kuro68k/PowerShift/hardware/data/webench_design_3873230_42_814646582.pdf

## WEBENCH ® Design Report

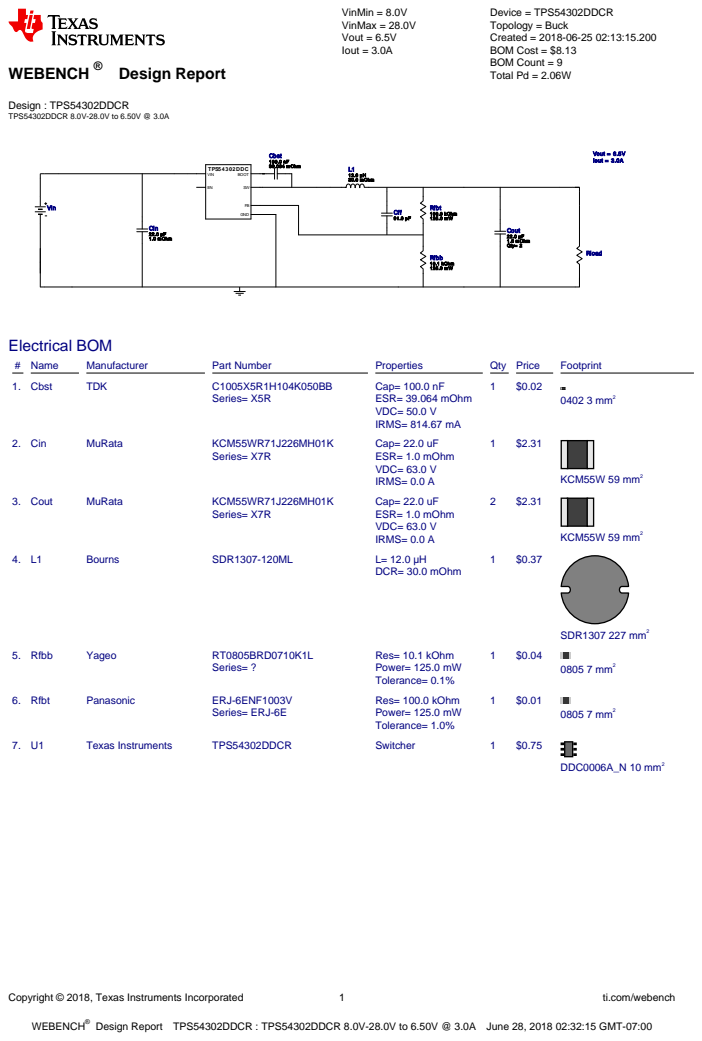
[picture p1: page 1]
Copyright © 2018, Texas Instruments Incorporated; ti.com/webench; WEBENCH®; Design : TPS54302DDCR TPS54302DDCR 8.0V-28.0V to 6.50V @ 3.0A; VinMin = 8.0V VinMax = 28.0V Vout = 6.5V Iout = 3.0A; Device = TPS54302DDCR Topology = Buck Created = 2018-06-25 02:13:15.200 BOM Cost = $8.13 BOM Count = 9 Total Pd = 2.06W; Cbst 100.0 nF; 39.064 mOhm; Cin 22.0 µF 1.0 mOhm; Cout 22.0 µF; 1.0 mOhm Qty= 2; L1 12.0 µH 30.0 mOhm; Rfbb 10.1 kOhm 125.0 mW; Rfbt 100.0 kOhm; TPS54302DDC; GND; VIN; BOOT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

Design Report TPS54302DDCR : TPS54302DDCR 8.0V-28.0V to 6.50V @ 3.0A June 28, 2018 02:32:15 GMT-07:00

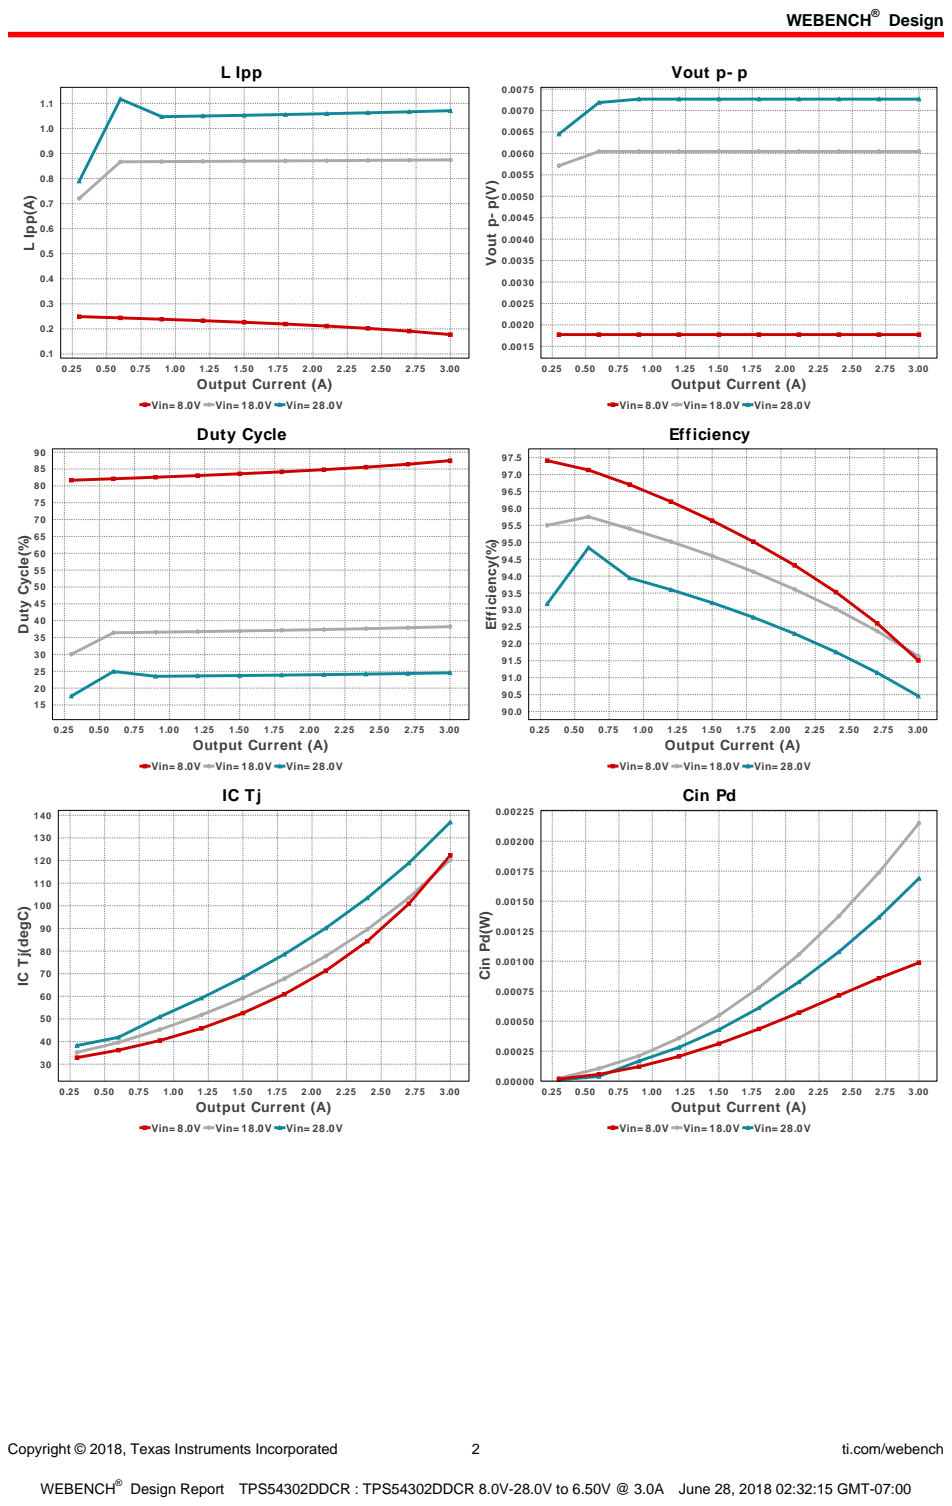
[picture p2: page 2]
Design; Copyright © 2018, Texas Instruments Incorporated; ti.com/webench; L Ipp; 3.00 Output Current (A); L Ipp(A); Vout p- p; Vout p- p(V); Duty Cycle(%); Efficiency(%); Cin Pd; Cin Pd(W)

Vin= 8.0V Vin= 18.0V Vin= 28.0V
Duty Cycle

Efficiency

IC Tj(degC)

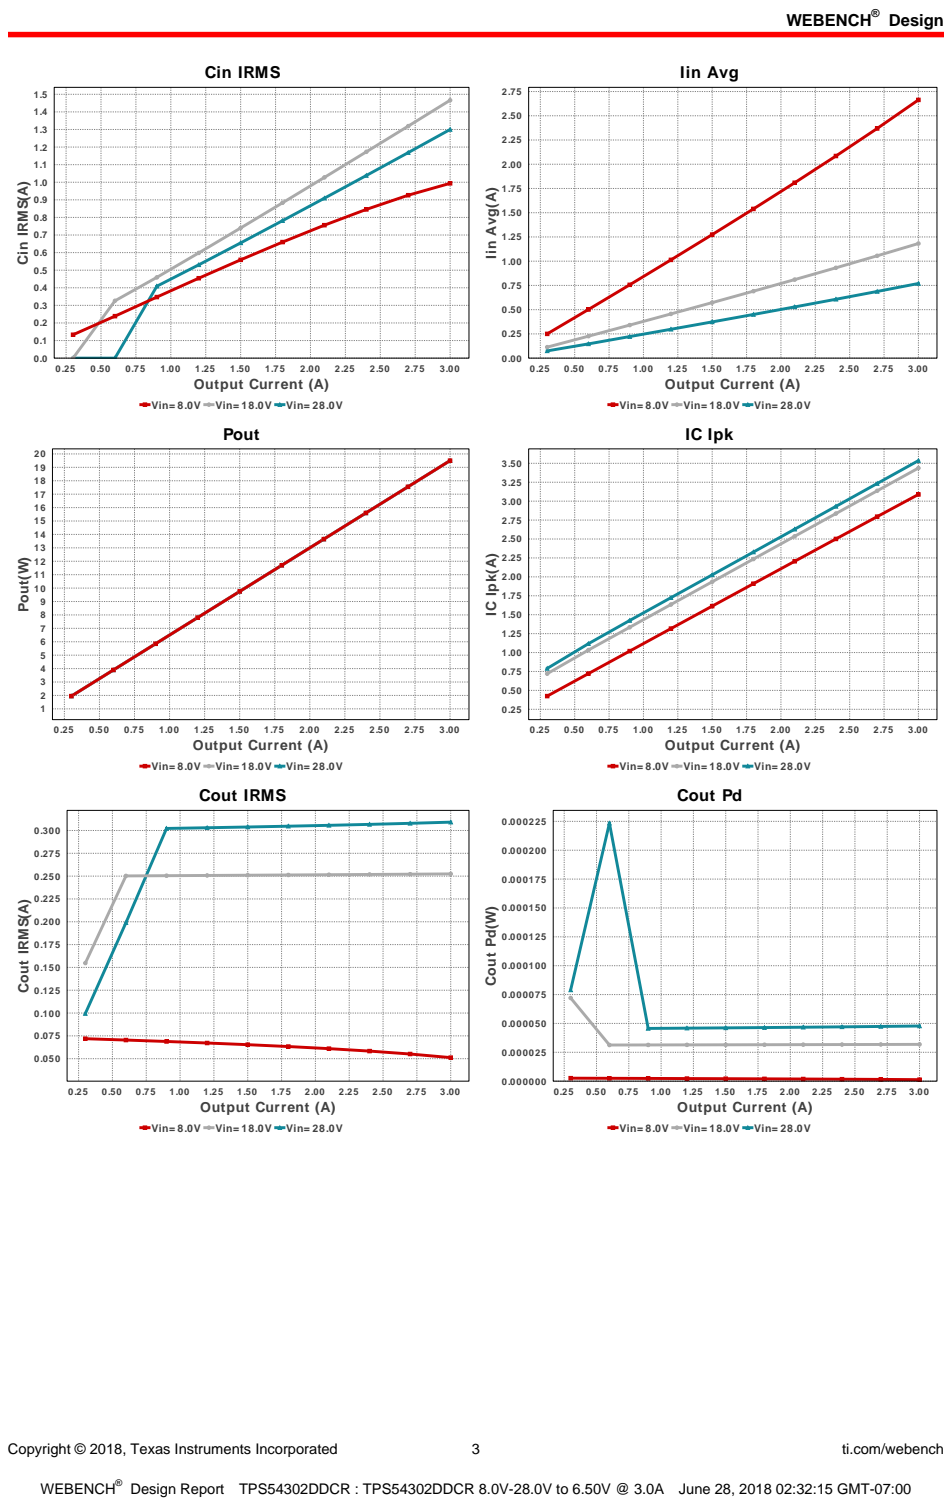
[picture p3: page 3]
Copyright © 2018, Texas Instruments Incorporated; ti.com/webench; Cin IRMS; 3.00 Output Current (A); Cin IRMS(A); Iin Avg; Iin Avg(A); Pout; Pout(W); IC Ipk; IC Ipk(A); Cout IRMS(A); 0.25 0.50 0.75 1.00 1.25 1.50 1.75 2.00 2.25 2.50 2.75 3.00 Output Current (A); Cout Pd(W)

Vin= 8.0V Vin= 18.0V Vin= 28.0V

Cout IRMS

Cout Pd

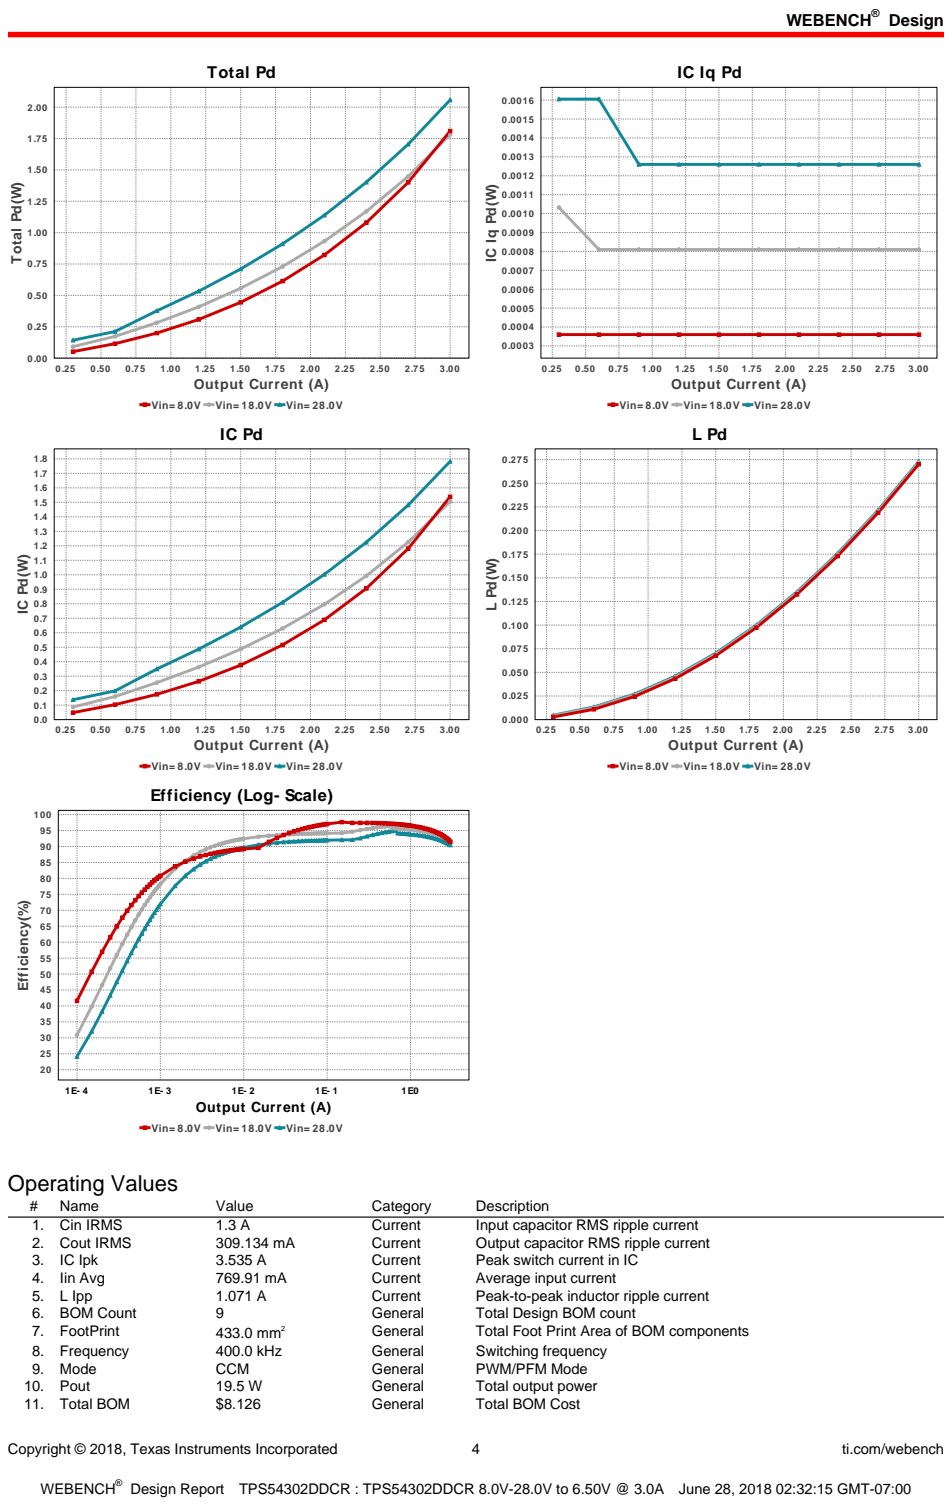
[picture p4: page 4]
Copyright © 2018, Texas Instruments Incorporated; ti.com/webench; Total Pd; 3.00 Output Current (A); Total Pd(W); 1E0 Output Current (A); Efficiency(%); Operating Values; Name; Value; Category; Description; 1. Cin IRMS; Current; Input capacitor RMS ripple current; 2. Cout IRMS; Output capacitor RMS ripple current; 3. IC Ipk; Peak switch current in IC; 4. Iin Avg; Average input current; 5. L Ipp; Peak-to-peak inductor ripple current; 6. BOM Count; General; Total Design BOM count; 7. FootPrint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

Vin= 8.0V Vin= 18.0V Vin= 28.0V

Efficiency (Log- Scale)

Copyright © 2018, Texas Instruments Incorporated | 5 | ti.com/webench
# | Name | Value | Category | Description

12. Duty Cycle | 24.54 % | Op Point | Duty cycle
13. Efficiency | 90.456 % | Op Point | Steady state efficiency
14. IC Tj | 136.945 degC | Op Point | IC junction temperature
15. ICThetaJA Effective | 60.0 degC/W | Op Point | Effective IC Junction-to-Ambient Thermal Resistance
16. IOUT_OP | 3.0 A | Op Point | Iout operating point
17. VIN_OP | 28.0 V | Op Point | Vin operating point
18. Vout Actual | 6.497 V | Op Point | Vout Actual calculated based on selected voltage divider resistors
19. Vout Tolerance | 1.0 % | Op Point | Vout Tolerance based on IC Tolerance (no load) and voltage divider
| | | | resistors if applicable
20. Vout p-p | 7.266 mV | Op Point | Peak-to-peak output ripple voltage
21. Cin Pd | 1.69 mW | Power | Input capacitor power dissipation
22. Cout Pd | 47.782 µW | Power | Output capacitor power dissipation
23. IC Iq Pd | 1.26 mW | Power | IC Iq Pd
24. IC Pd | 1.782 W | Power | IC power dissipation
25. L Pd | 272.867 mW | Power | Inductor power dissipation
26. Total Pd | 2.057 W | Power | Total Power Dissipation

## Design Inputs

# | Name | Value | Description

1. Iout | 3.0 | Maximum Output Current
2. VinMax | 28.0 | Maximum input voltage
3. VinMin | 8.0 | Minimum input voltage
4. Vout | 6.5 | Output Voltage
5. acFrequency | 0.0 | AC Frequency
6. base_pn | TPS54302 | Base Product Number
7. source | DC | Input Source Type
8. Ta | 30.0 | Ambient temperature

## Design Assistance

1. TPS54302 Product Folder : http://www.ti.com/product/TPS54302 : contains the data sheet and other resources.

Texas Instruments' WEBENCH simulation tools attempt to recreate the performance of a substantially equivalent physical implementation
of the design. Simulations are created using Texas Instruments' published specifications as well as the published specifications of other device manufacturers. While Texas Instruments does update this information periodically, this information may not be current at the time the simulation is built. Texas Instruments does not warrant the accuracy or completeness of the specifications or any information contained therein. Texas Instruments does not warrant that any designs or recommended parts will meet the specifications you entered, will be suitable for your application or fit for any particular purpose, or will operate as shown in the simulation in a physical implementation. Texas Instruments does not warrant that the designs are production worthy.
You should completely validate and test your design implementation to confirm the system functionality for your application prior to production.
Use of Texas Instruments' WEBENCH simulation tools is subject to Texas Instruments' Site Terms and Conditions of Use. (http://www.ti.com/corp/docs/legal/termsofuse.shtml) Prototype boards based on WEBENCH created designs are provided AS IS without warranty of any kind for evaluation and testing purposes and are subject to the terms of the Evaluation License Agreement. (http://www.ti.com/corp/docs/legal/termsofuse_estore.shtml)
