kuro68k/PowerShift/hardware/PowerShift.pdf

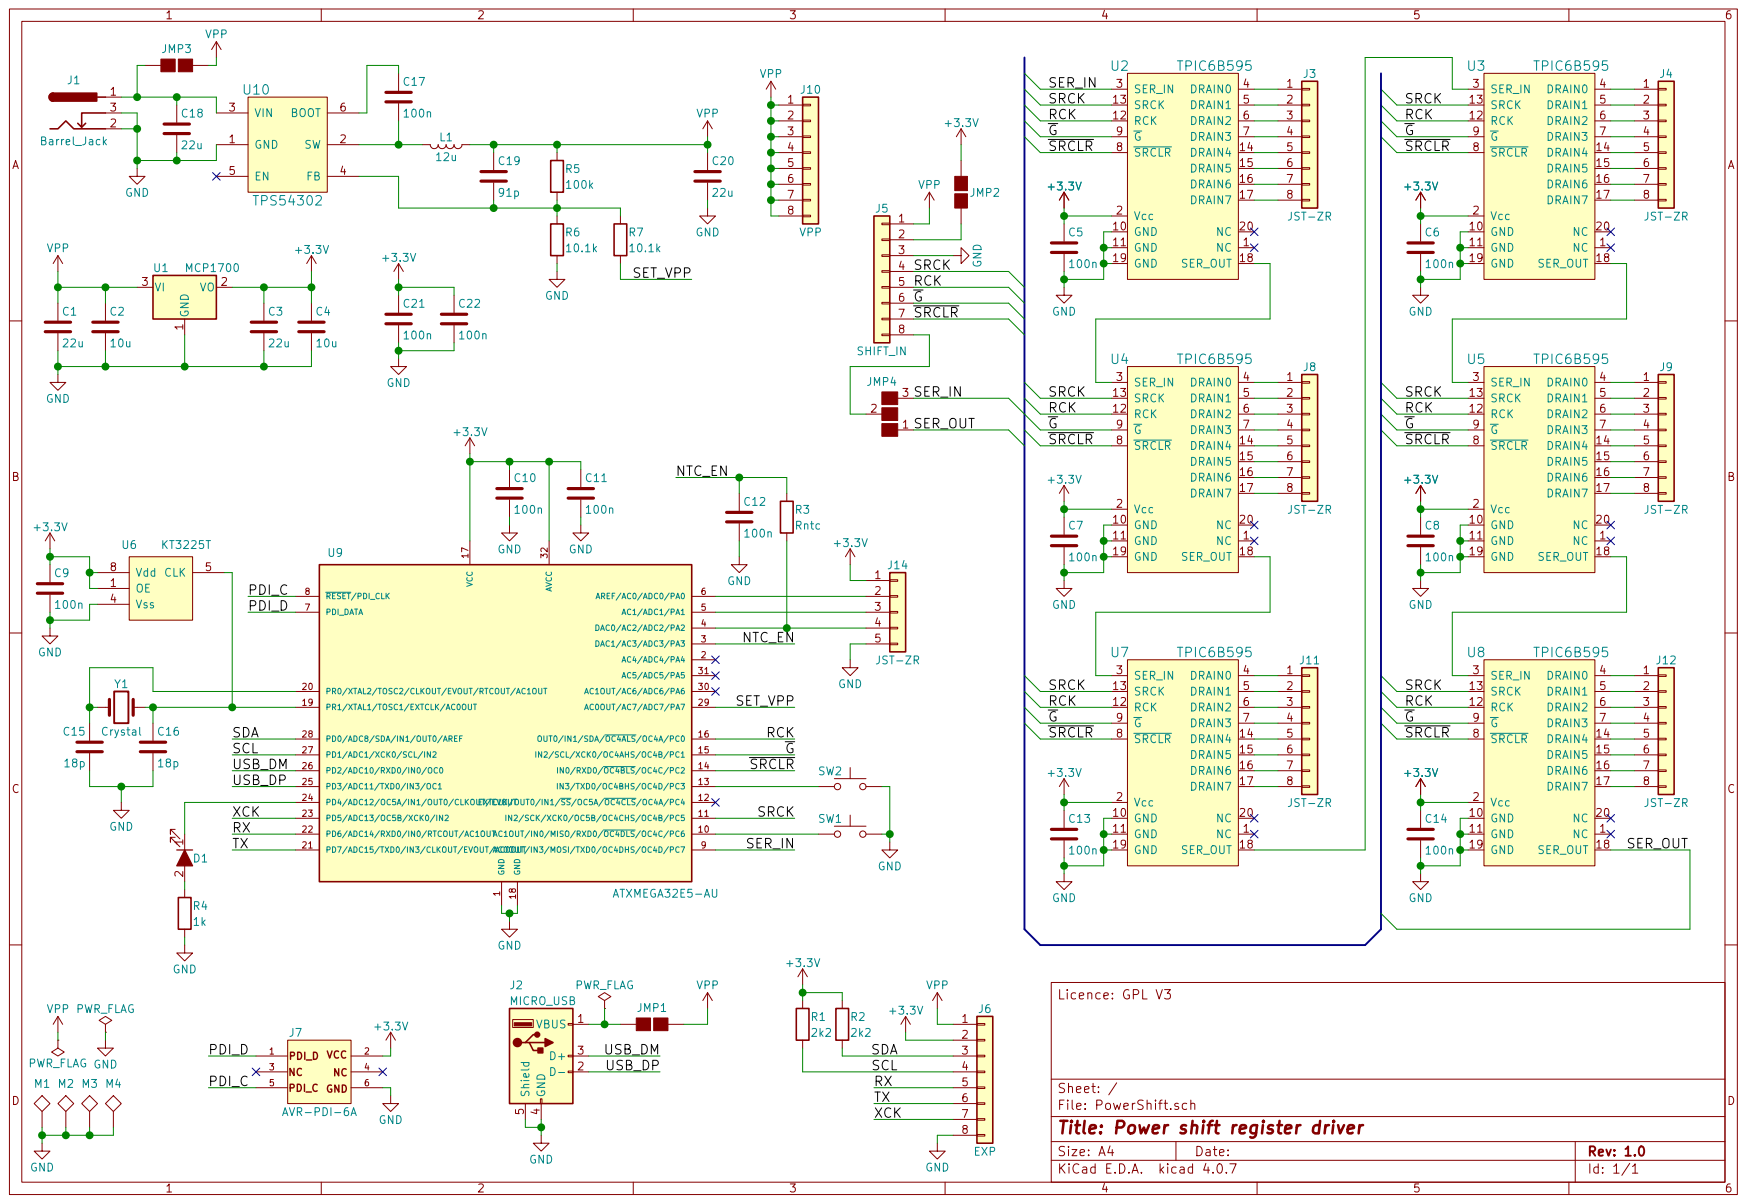
[picture p5: page 1]
