kuro68k/PowerShift/hardware/PowerShift.kicad_pcb

## KiCad design hardware/PowerShift.kicad_pcb (2018-07-08)

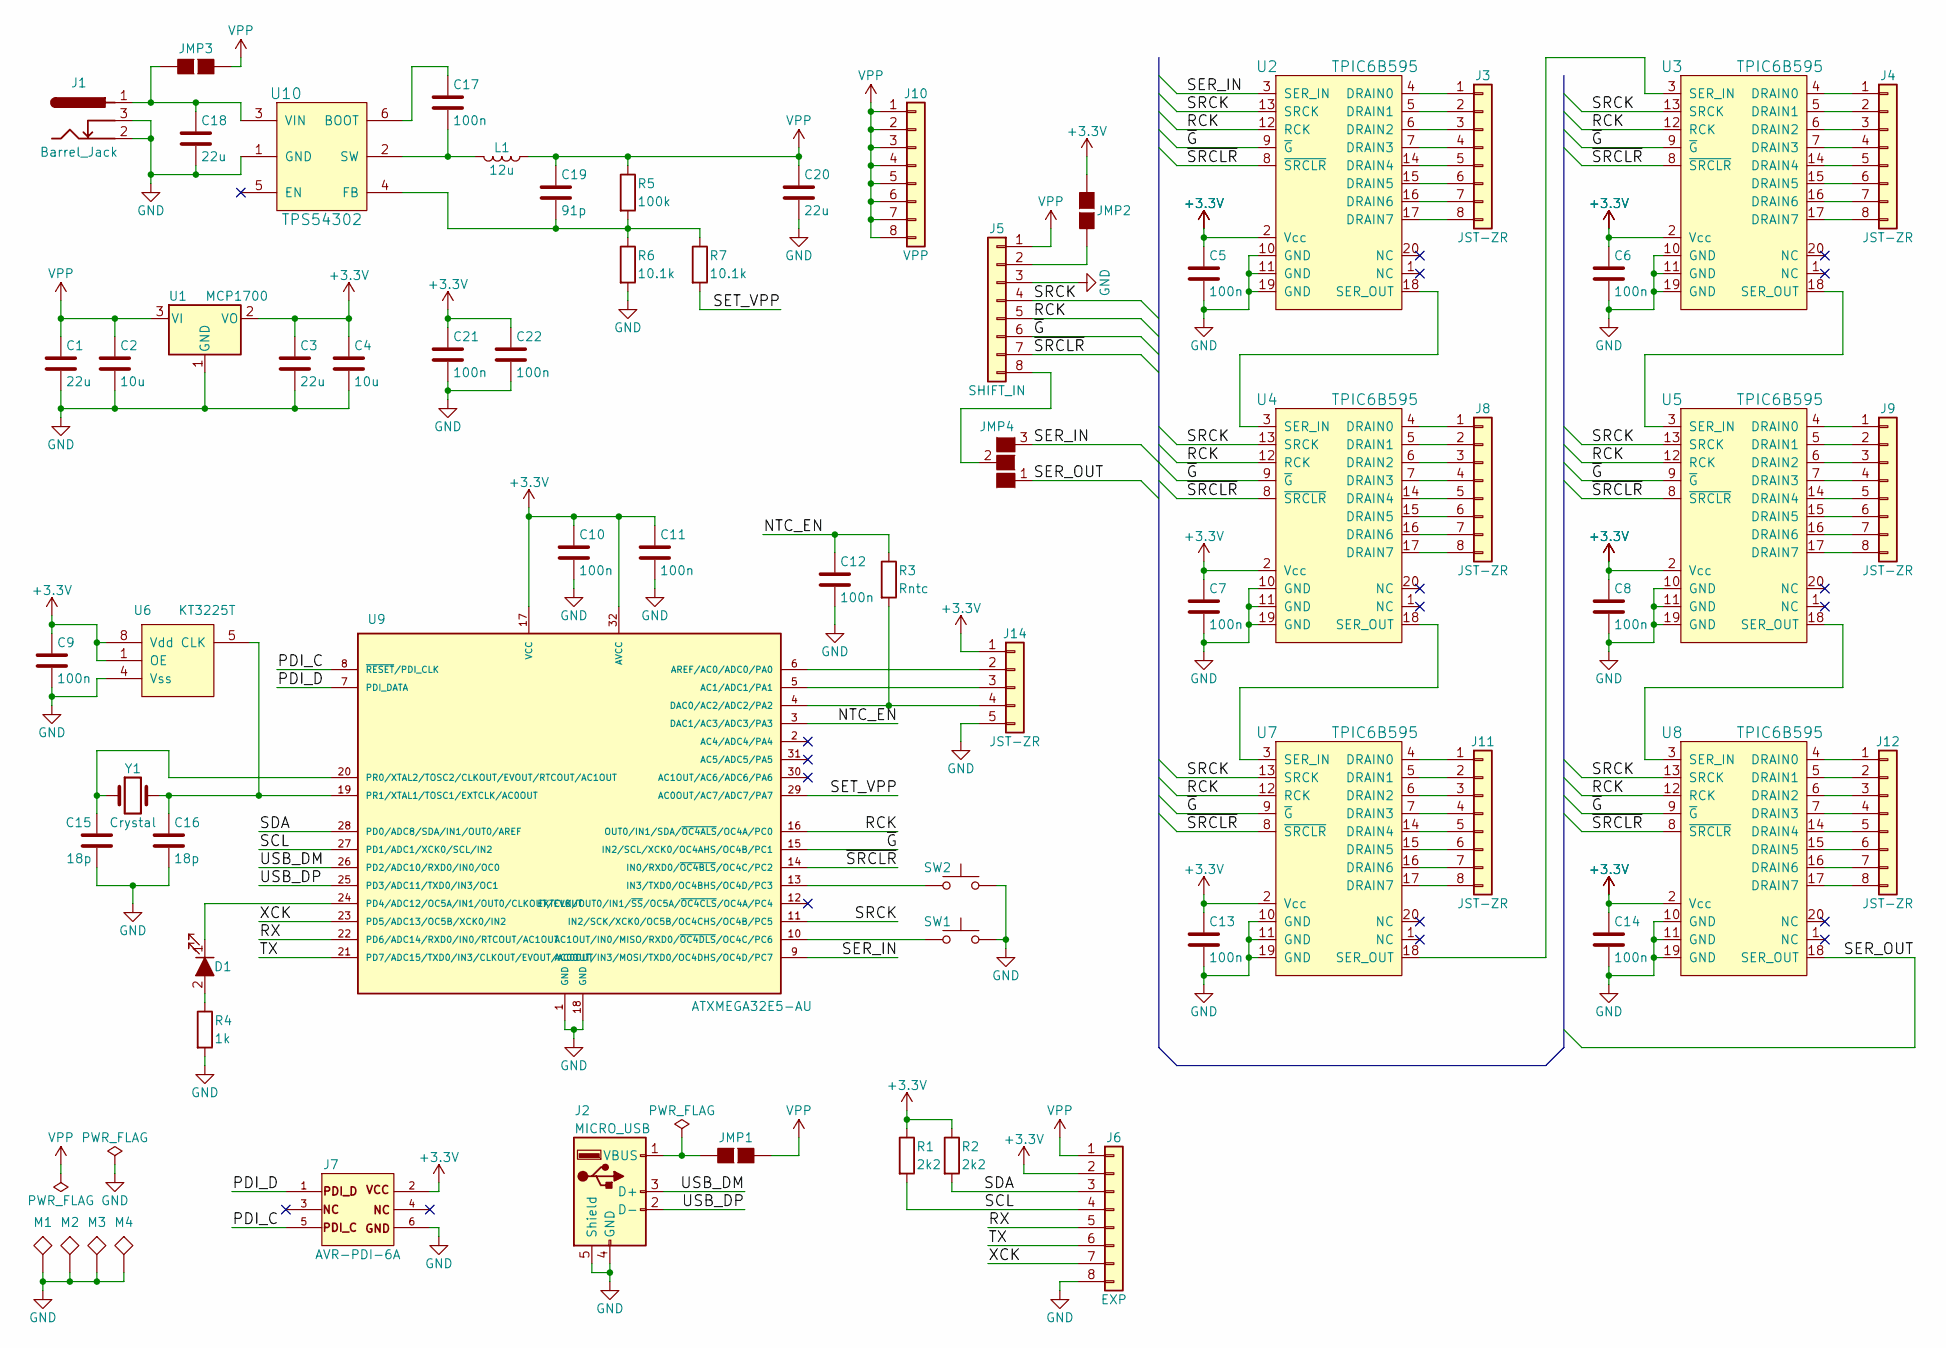
[picture p6: schematic PowerShift.sch, Power shift register driver]

Parts:
C1, C3, C18, C20: 22u; C_0805_HandSoldering
C2, C4: 10u; C_0603_HandSoldering
C5, C6, C7, C8, C9, C10, C11, C12, C13, C14, C17, C21, C22: 100n; C_0603_HandSoldering
C15, C16: 18p; C_0603_HandSoldering
C19: 91p; C_0603_HandSoldering
D1: LED_ALT; LED_0603_HandSoldering
J1: Barrel_Jack; DC_Jack_SMD_FC6814xS_6941
J2: MICRO_USB; Molex_47346-0001_Micro_USB_SMT
J3, J4, J8, J9, J11, J12: JST-ZR; B8B-ZR-SM4-TF
J5: SHIFT_IN; Pin_Header_Straight_1x08_Pitch2.54mm
J6: EXP; B8B-ZR-SM4-TF
J7: AVR-PDI-6A; Pin_Header_Angled_2x03_Pitch2.54mm
J10: VPP; B8B-ZR-SM4-TF
J14: JST-ZR; B5B-ZR-SM4-TF
JMP1, JMP2, JMP3: GS2
JMP4: GS3
L1: 12u; Bourns_SDR1307_14x14mm
M1, M2, M3, M4: TEST; MountingHole_2.7mm_M2.5_Pad
R1, R2: 2k2; R_0603_HandSoldering
R3: Rntc; R_0603_HandSoldering
R4: 1k; R_0603_HandSoldering
R5: 100k; R_0603_HandSoldering
R6, R7: 10.1k; R_0603_HandSoldering
SW1, SW2: SW_Push; Switch_FSM-JSM-Series
U1: MCP1700; SOT-23
U2, U3, U4, U5, U7, U8: TPIC6B595; SOIC-20W_7.5x12.8mm_Pitch1.27mm
U6: KT3225T
U9: ATXMEGA32E5-AU; TQFP-32_7x7mm_Pitch0.8mm
U10: TPS54302; SOT-23-6_Handsoldering
Y1: Crystal; Crystal_2pin_6x3.5_3.2x1.5_Multi

Connections:
+3V3: C3.1, C4.1, C5.1, C6.1, C7.1, C8.1, C9.1, C10.1, C11.1, C13.1, C14.1, C21.1, C22.1, J6.2, J7.2, J14.1, JMP2.1 (G1), R1.1, R2.1, U1.2 (VO), U2.2 (Vcc), U3.2 (Vcc), U4.2 (Vcc), U5.2 (Vcc), U6.1 (OE), U6.8 (Vdd), U7.2 (Vcc), U8.2 (Vcc), U9.17 (VCC), U9.32 (AVCC)
/NTC_EN: C12.1, R3.1, U9.3 (DAC1/AC3/ADC3/PA3)
/PDI_C: J7.5, U9.8 (~RESET~/PDI_CLK)
/PDI_D: J7.1, U9.7 (PDI_DATA)
/RCK: J5.5, U2.12 (RCK), U3.12 (RCK), U4.12 (RCK), U5.12 (RCK), U7.12 (RCK), U8.12 (RCK), U9.16 (OUT0/IN1/SDA/~OC4ALS~/OC4A/PC0)
/RX: J6.5, U9.22 (PD6/ADC14/RXD0/IN0/RTCOUT/AC1OUT)
/SCL: J6.4, R1.2, U9.27 (PD1/ADC1/XCK0/SCL/IN2)
/SDA: J6.3, R2.2, U9.28 (PD0/ADC8/SDA/IN1/OUT0/AREF)
/SER_IN: JMP4.3 (G3), U2.3 (SER_IN), U9.9 (AC0OUT/IN3/MOSI/TXD0/OC4DHS/OC4D/PC7)
/SER_OUT: JMP4.1 (G1), U8.18 (SER_OUT)
/SET_VPP: R7.2, U9.29 (AC0OUT/AC7/ADC7/PA7)
/SRCK: J5.4, U2.13 (SRCK), U3.13 (SRCK), U4.13 (SRCK), U5.13 (SRCK), U7.13 (SRCK), U8.13 (SRCK), U9.11 (IN2/SCK/XCK0/OC5B/OC4CHS/OC4B/PC5)
/TX: J6.6, U9.21 (PD7/ADC15/TXD0/IN3/CLKOUT/EVOUT/AC0OUT)
/USB_DM: J2.3 (D+), U9.26 (PD2/ADC10/RXD0/IN0/OC0)
/USB_DP: J2.2 (D-), U9.25 (PD3/ADC11/TXD0/IN3/OC1)
/XCK: J6.7, U9.23 (PD5/ADC13/OC5B/XCK0/IN2)
/~G: J5.6, U2.9 (~G), U3.9 (~G), U4.9 (~G), U5.9 (~G), U7.9 (~G), U8.9 (~G), U9.15 (IN2/SCL/XCK0/OC4AHS/OC4B/PC1)
/~SRCLR: J5.7, U2.8 (~SRCLR), U3.8 (~SRCLR), U4.8 (~SRCLR), U5.8 (~SRCLR), U7.8 (~SRCLR), U8.8 (~SRCLR), U9.14 (IN0/RXD0/~OC4BLS~/OC4C/PC2)
GND: C1.2, C2.2, C3.2, C4.2, C5.2, C6.2, C7.2, C8.2, C9.2, C10.2, C11.2, C12.2, C13.2, C14.2, C15.2, C16.2, C18.2, C20.2, C21.2, C22.2, J1.2, J1.3, J2.4 (GND), J2.5 (Shield), J5.3, J6.8, J7.6, J14.5, M1.1, M2.1, M3.1, M4.1, R4.2, R6.2, SW1.1, SW2.1, U1.1 (GND), U2.10 (GND), U2.11 (GND), U2.19 (GND), U3.10 (GND), U3.11 (GND), U3.19 (GND), U4.10 (GND), U4.11 (GND), U4.19 (GND), U5.10 (GND), U5.11 (GND), U5.19 (GND), U6.4 (Vss), U7.10 (GND), U7.11 (GND), U7.19 (GND), U8.10 (GND), U8.11 (GND), U8.19 (GND), U9.1 (GND), U9.18 (GND), U10.1 (GND)
unnamed: C15.1, U9.20 (PR0/XTAL2/TOSC2/CLKOUT/EVOUT/RTCOUT/AC1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), Y1.1
unnamed: C16.1, U6.5 (CLK), U9.19 (PR1/XTAL1/TOSC1/EXTCLK/AC0OUT), Y1.2
unnamed: C17.1, U10.6 (BOOT)
unnamed: C17.2, L1.2, U10.2 (SW)
unnamed: C18.1, J1.1, JMP3.1 (G1), U10.3 (VIN)
unnamed: C19.2, R5.2, R6.1, R7.1, U10.4 (FB)
unnamed: D1.1 (K), U9.24 (PD4/ADC12/OC5A/IN1/OUT0/CLKOUT/EVOUT)
unnamed: D1.2 (A), R4.1
unnamed: J2.1 (VBUS), JMP1.1 (G1)
unnamed: J3.1, U2.4 (DRAIN0)
unnamed: J3.2, U2.5 (DRAIN1)
unnamed: J3.3, U2.6 (DRAIN2)
unnamed: J3.4, U2.7 (DRAIN3)
unnamed: J3.5, U2.14 (DRAIN4)
unnamed: J3.6, U2.15 (DRAIN5)
unnamed: J3.7, U2.16 (DRAIN6)
unnamed: J3.8, U2.17 (DRAIN7)
unnamed: J4.1, U3.4 (DRAIN0)
unnamed: J4.2, U3.5 (DRAIN1)
unnamed: J4.3, U3.6 (DRAIN2)
unnamed: J4.4, U3.7 (DRAIN3)
unnamed: J4.5, U3.14 (DRAIN4)
unnamed: J4.6, U3.15 (DRAIN5)
unnamed: J4.7, U3.16 (DRAIN6)
unnamed: J4.8, U3.17 (DRAIN7)
unnamed: J5.2, JMP2.2 (G2)
unnamed: J5.8, JMP4.2 (G2)
unnamed: J8.1, U4.4 (DRAIN0)
unnamed: J8.2, U4.5 (DRAIN1)
unnamed: J8.3, U4.6 (DRAIN2)
unnamed: J8.4, U4.7 (DRAIN3)
unnamed: J8.5, U4.14 (DRAIN4)
unnamed: J8.6, U4.15 (DRAIN5)
unnamed: J8.7, U4.16 (DRAIN6)
unnamed: J8.8, U4.17 (DRAIN7)
unnamed: J9.1, U5.4 (DRAIN0)
unnamed: J9.2, U5.5 (DRAIN1)
unnamed: J9.3, U5.6 (DRAIN2)
unnamed: J9.4, U5.7 (DRAIN3)
unnamed: J9.5, U5.14 (DRAIN4)
unnamed: J9.6, U5.15 (DRAIN5)
unnamed: J9.7, U5.16 (DRAIN6)
unnamed: J9.8, U5.17 (DRAIN7)
unnamed: J11.1, U7.4 (DRAIN0)
unnamed: J11.2, U7.5 (DRAIN1)
unnamed: J11.3, U7.6 (DRAIN2)
unnamed: J11.4, U7.7 (DRAIN3)
unnamed: J11.5, U7.14 (DRAIN4)
unnamed: J11.6, U7.15 (DRAIN5)
unnamed: J11.7, U7.16 (DRAIN6)
unnamed: J11.8, U7.17 (DRAIN7)
unnamed: J12.1, U8.4 (DRAIN0)
unnamed: J12.2, U8.5 (DRAIN1)
unnamed: J12.3, U8.6 (DRAIN2)
unnamed: J12.4, U8.7 (DRAIN3)
unnamed: J12.5, U8.14 (DRAIN4)
unnamed: J12.6, U8.15 (DRAIN5)
unnamed: J12.7, U8.16 (DRAIN6)
unnamed: J12.8, U8.17 (DRAIN7)
unnamed: J14.2, U9.6 (AREF/AC0/ADC0/PA0)
unnamed: J14.3, U9.5 (AC1/ADC1/PA1)
unnamed: J14.4, R3.2, U9.4 (DAC0/AC2/ADC2/PA2)
unnamed: SW1.2, U9.10 (AC1OUT/IN0/MISO/RXD0/~OC4DLS~/OC4C/PC6)
unnamed: SW2.2, U9.13 (IN3/TXD0/OC4BHS/OC4D/PC3)
unnamed: U2.18 (SER_OUT), U4.3 (SER_IN)
unnamed: U3.3 (SER_IN), U7.18 (SER_OUT)
unnamed: U3.18 (SER_OUT), U5.3 (SER_IN)
unnamed: U4.18 (SER_OUT), U7.3 (SER_IN)
unnamed: U5.18 (SER_OUT), U8.3 (SER_IN)
VPP: C1.1, C2.1, C19.1, C20.1, J5.1, J6.1, J10.1, J10.2, J10.3, J10.4, J10.5, J10.6, J10.7, J10.8, JMP1.2 (G2), JMP3.2 (G2), L1.1, R5.1, U1.3 (VI)

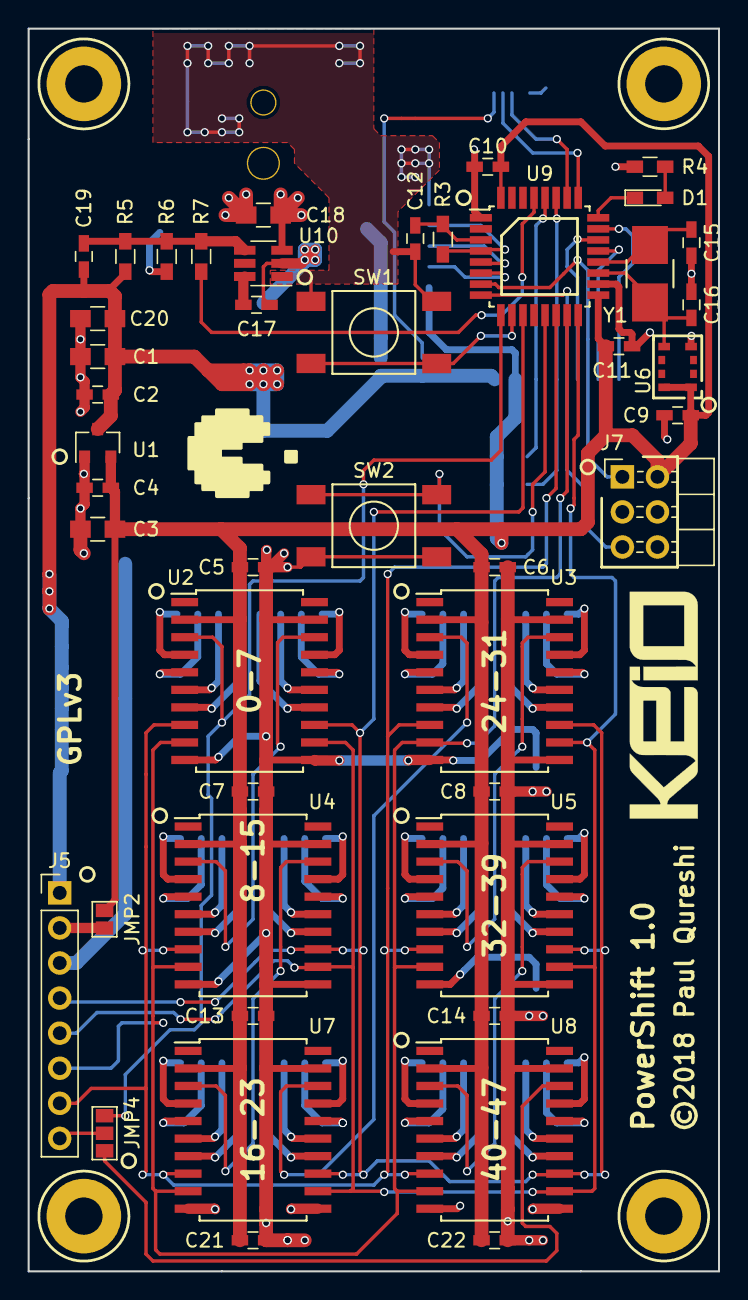
[picture p7: board PowerShift.kicad_pcb from above]

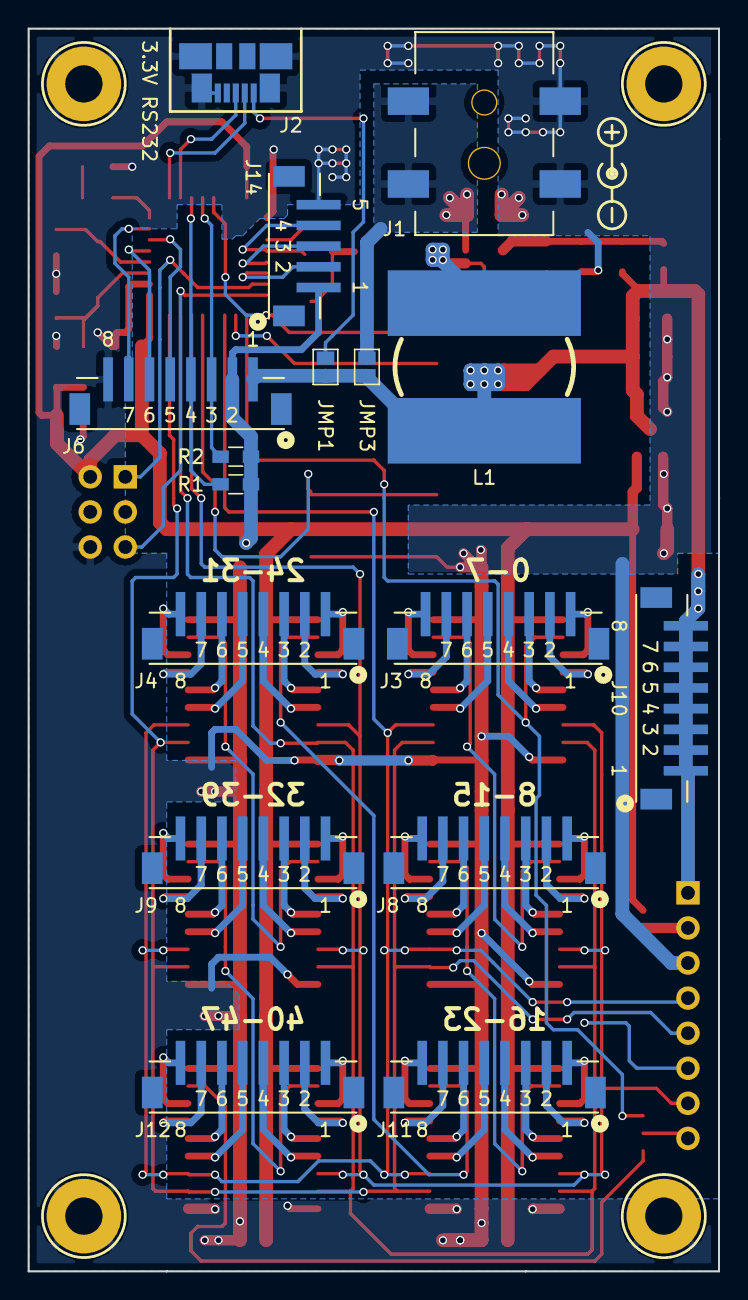
[picture p8: board PowerShift.kicad_pcb from below]

Board: 2 copper layers, 50.0 x 90.0 mm, 65 parts (16 on the bottom side), 89 nets.
