kuro68k/PowerShift/(commit log)

2018-06-24 RS232 expansion
    [PowerShift.sch]
2018-06-24 JST 5 pin common part
    [PowerShift.sch]
2018-06-24 ERC OK
    [PowerShift.sch]
2018-06-25 Step down regulator
    [PowerShift.sch]
2018-06-25 Buck reg bypass
    [PowerShift.sch]
2018-06-25 Test driver/header layout
    [PowerShift.kicad_pcb]
2018-06-26 Additional shift reg caps
    [PowerShift.sch]
2018-06-26 PDI header to 1.27mm SMD
    [PowerShift.sch]
2018-06-26 Shift registers laid out
    [PowerShift.kicad_pcb]
2018-06-26 MCU planning
    [PowerShift.kicad_pcb]
2018-06-26 DC jack footprint
    [PowerShift.sch]
2018-06-26 Power supply layout
    [PowerShift.kicad_pcb]
2018-06-26 Combined in/out header
    [PowerShift.sch]
2018-06-26 Mounting holes
    [PowerShift.sch]
2018-06-26 Display power header
    [PowerShift.sch]
2018-06-26 Aligned drivers
    [PowerShift.kicad_pcb]
2018-06-26 Board outline
    [PowerShift.kicad_pcb]
2018-06-26 All on board
    [PowerShift.kicad_pcb]
2018-06-27 R/A PDI header footprint
    [PowerShift.sch]
2018-06-27 GND plane and 3V3 supply
    [PowerShift.kicad_pcb]
2018-06-27 Nearly there
    [PowerShift.kicad_pcb]
2018-06-27 All nets connected, DRC OK
    [PowerShift.kicad_pcb]
2018-06-27 Top silk
    [PowerShift.kicad_pcb]
2018-06-28 Corrected top silk for buttons
    [PowerShift.kicad_pcb]
2018-06-28 Bottom silk
    [PowerShift.kicad_pcb]
2018-06-28 Top silk fix
    [PowerShift.kicad_pcb]
2018-06-28 Plot output
    [PowerShift.kicad_pcb]
2018-06-28 Added BOM
2018-06-28 Multi footprint crystal
    [PowerShift.kicad_pcb, PowerShift.sch]
2018-06-28 Corrected dimension marker
    [PowerShift.kicad_pcb]
2018-06-28 Cleaned up schematic layout
    [PowerShift.kicad_pcb, PowerShift.sch]
2018-07-04 Added PDF of schematic
2018-07-04 Silk on silk layers
    [PowerShift.kicad_pcb]
2018-07-04 Keio logo on silk layer
    [PowerShift.kicad_pcb]
2018-07-05 Pin 1 marker for U10
    [PowerShift.kicad_pcb]
2018-07-05 Silkscreen for U6
    [PowerShift.kicad_pcb]
2018-07-08 Added Vpp voltage switch
    [PowerShift.kicad_pcb, PowerShift.sch]
2018-07-09 Updated PDF schematic
