kuro68k/PowerShift/(notices)

Notices in the files:
hardware/PowerShift.sch:
Licence: GPL V3
hardware/PowerShift.kicad_pcb:
©2018 Paul Qureshi
